IdeaPropulsionSystems/TimeLapseRail/TimeLapseRail/3D_Objects/170921_TinkercadScreenShotLabeled.jpg

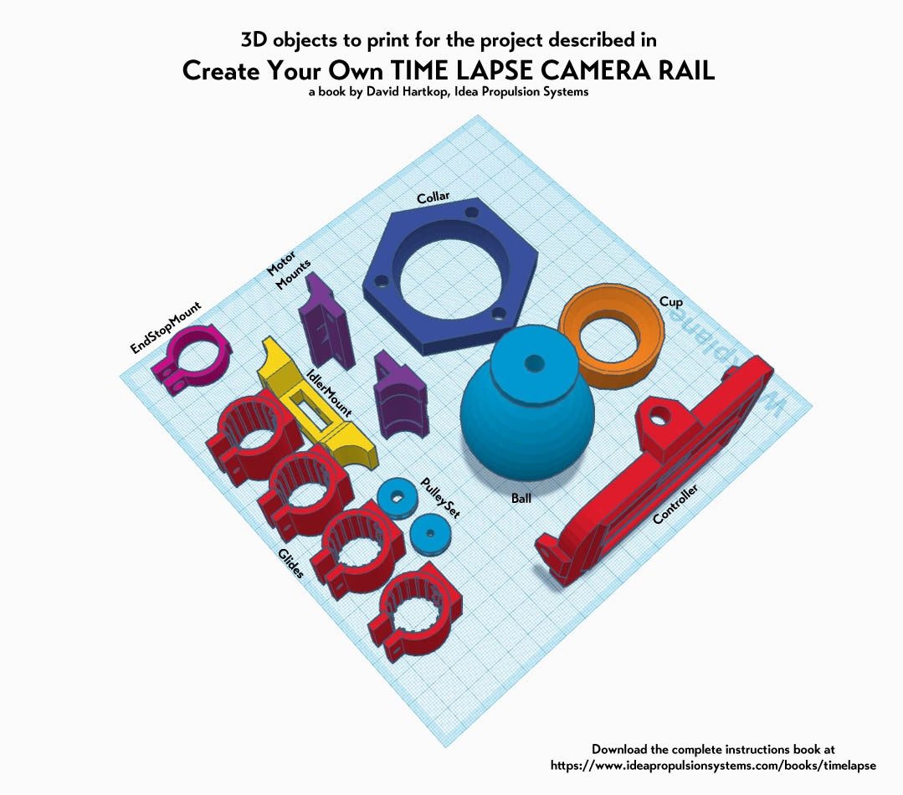
TimeLapseRail/3D_Objects/170921_TinkercadScreenShotLabeled.jpg
