IdeaPropulsionSystems/TimeLapseRail/TimeLapseRail/Notes/Time Lapse Table - Sheet1 (1).pdf

# How long do I have to sit here??!

Frames of TimeLapse
| 30 | 150 | 300 | 450 | 600 | 900 | 1800

Camera Interval

0:05 | 0:02:30 | 0:12:30 | 0:25:00 | 0:37:30 | 0:50:00 | 1:15:00 | 2:30:00
0:10 | 0:05:00 | 0:25:00 | 0:50:00 | 1:15:00 | 1:40:00 | 2:30:00 | 5:00:00
0:15 | 0:07:30 | 0:37:30 | 1:15:00 | 1:52:30 | 2:30:00 | 3:45:00 | 7:30:00
0:20 | 0:10:00 | 0:50:00 | 1:40:00 | 2:30:00 | 3:20:00 | 5:00:00 | 10:00:00
0:30 | 0:15:00 | 1:15:00 | 2:30:00 | 3:45:00 | 5:00:00 | 7:30:00 | 15:00:00
0:40 | 0:20:00 | 1:40:00 | 3:20:00 | 5:00:00 | 6:40:00 | 10:00:00 | 20:00:00
0:50 | 0:25:00 | 2:05:00 | 4:10:00 | 6:15:00 | 8:20:00 | 12:30:00 | 25:00:00
1:00 | 0:30:00 | 2:30:00 | 5:00:00 | 7:30:00 | 10:00:00 | 15:00:00 | 30:00:00
2:00 | 1:00:00 | 5:00:00 | 10:00:00 | 15:00:00 | 20:00:00 | 30:00:00 | 60:00:00
| 1 | 5 | 10 | 15 | 20 | 30 | 60
Seconds of TimeLapse (30fps)
