IdeaPropulsionSystems/TimeLapseRail/TimeLapseRail/Notes/CamRail_3DPartslist - Sheet1.pdf

Part No. | Part Name | File Name | *Print Profile | Print Time (hr : min) | Weight (g) | Quantity
1 | Camera Mount Ball | 170708_Ball.stl | A | 1:45 | 45 | 1
2 | Controller Panel Face | 170708_Controller.stl | A | 1:30 | 30.5 | 1
3 | Idler Pulley Mount | 170708_IdlerMount.stl | A | 0:25 | 9 | 1
4 | Motor Mounts | 170708_MotorMounts.stl | A | 0:34 | 12 | 1
5 | Camera Mount Collar | 170708_Collar.stl | A | 0:48 | 19 | 1
6 | Endstop Switch Mount | 170708_EndstopMount.stl | A | 0:07 | 3 | 1
7 | Linear Bearing Glides | 170708_Glides.stl | A | 1:43 | 32 | 1
8 | Pulley Set | 170708_PulleySet.stl | B | 0:04 | 1.5 | 1
9 | Camera Mount Cup | 170708_Cup.stl | C | 0:17 | 6.2 | 1

*Print Profiles:
A: 0.2 mm layer thickness, 3 shells, 50% infill, raft + supports
B: 0.2 mm layer thickness, 3 shells, 100% infill, no raft or supports C: 0.2 mm layer thickness, 2 shells, 25% infill, no raft or supports
