IdeaPropulsionSystems/TimeLapseRail/TimeLapseRail/3D_Objects/170921_EndStopMount.stl

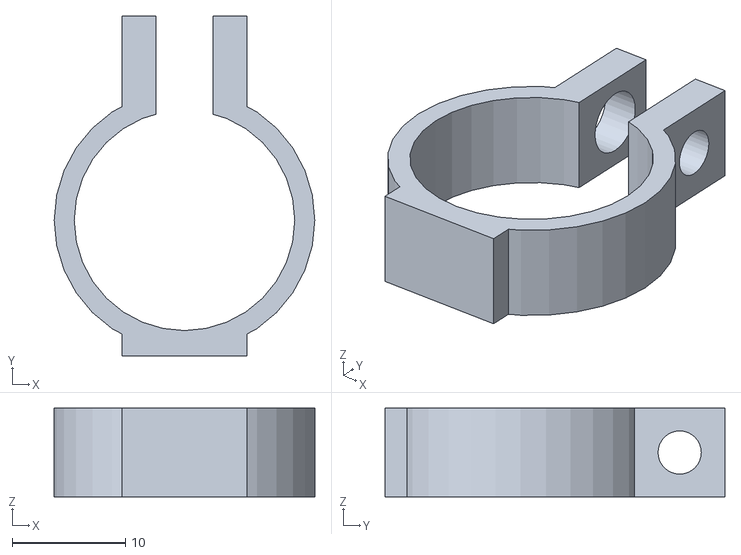
[picture p2: CAD file, 2017-09-21]
TimeLapseRail/3D_Objects/170921_EndStopMount.stl
23.0 x 30.0 x 7.84
