IdeaPropulsionSystems/TimeLapseRail/TimeLapseRail/3D_Objects/170921_Controller.stl

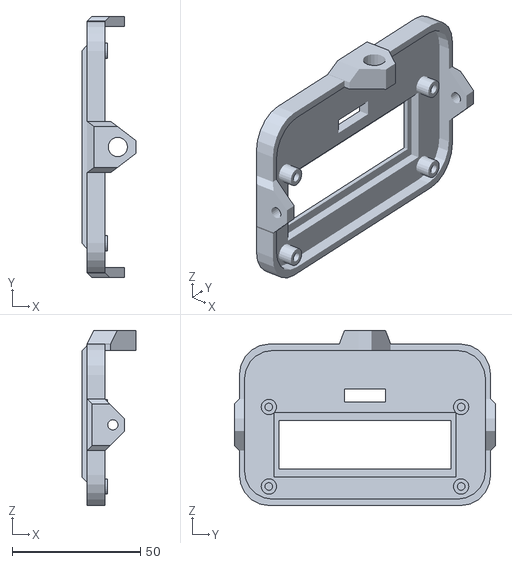
[picture p3: CAD file, 2017-09-21]
TimeLapseRail/3D_Objects/170921_Controller.stl
21.0 x 102.0 x 68.3
