IdeaPropulsionSystems/TimeLapseRail/TimeLapseRail/3D_Objects/170921_PulleySet.stl

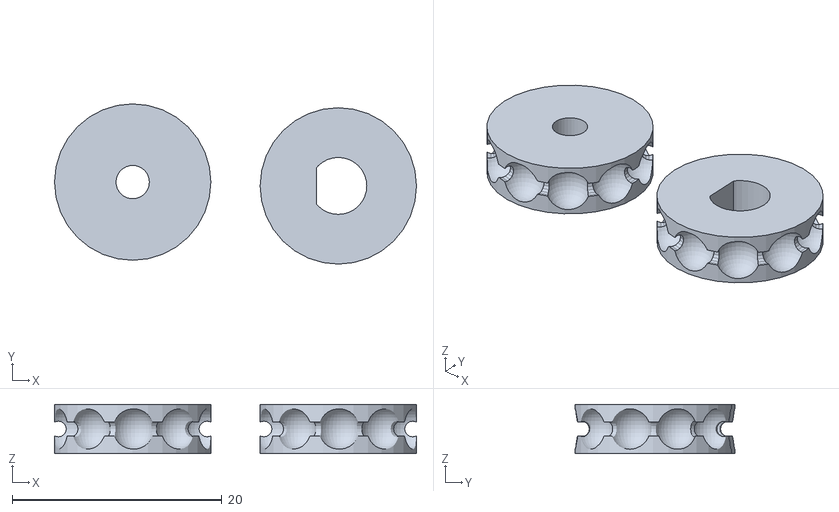
[picture p4: CAD file, 2017-09-21]
TimeLapseRail/3D_Objects/170921_PulleySet.stl
34.5 x 15.3 x 4.71
