IdeaPropulsionSystems/TimeLapseRail/TimeLapseRail/3D_Objects/170921_Glides.stl

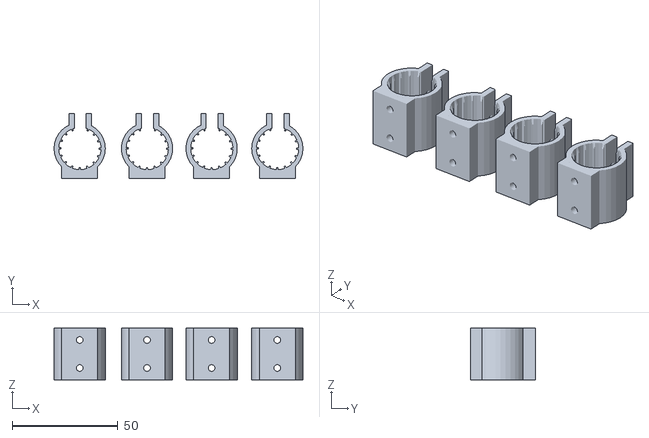
[picture p5: CAD file, 2017-09-21]
TimeLapseRail/3D_Objects/170921_Glides.stl
117.7 x 30.9 x 24.5
