IdeaPropulsionSystems/TimeLapseRail/TimeLapseRail/3D_Objects/170921_Cup.stl

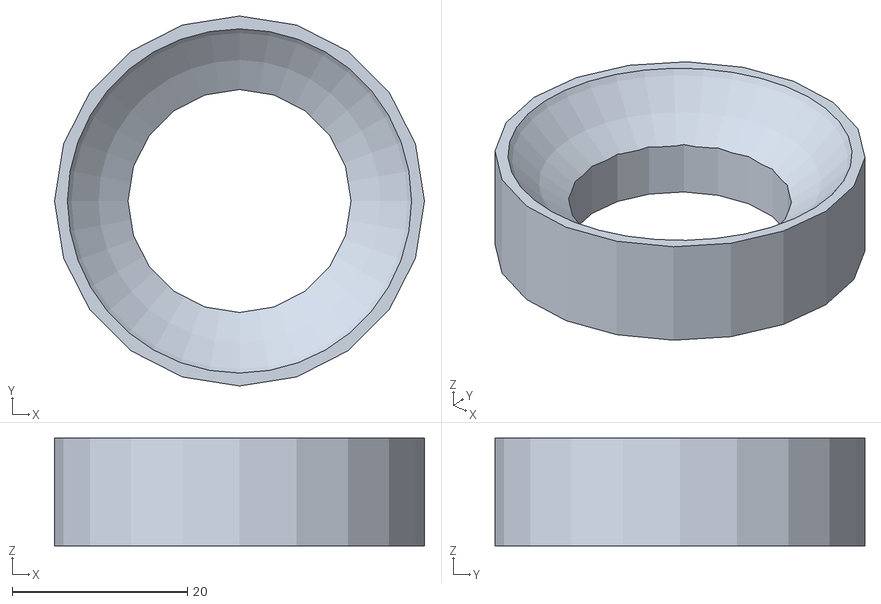
[picture p6: CAD file, 2017-09-21]
TimeLapseRail/3D_Objects/170921_Cup.stl
42.2 x 42.2 x 12.3
