IdeaPropulsionSystems/TimeLapseRail/TimeLapseRail/3D_Objects/170921_Collar.stl

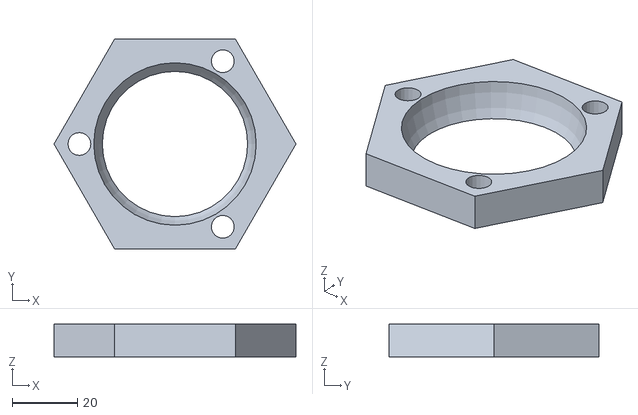
[picture p7: CAD file, 2017-09-21]
TimeLapseRail/3D_Objects/170921_Collar.stl
74.2 x 64.2 x 10.00
