IdeaPropulsionSystems/TimeLapseRail/TimeLapseRail/3D_Objects/170921_IdlerMount.stl

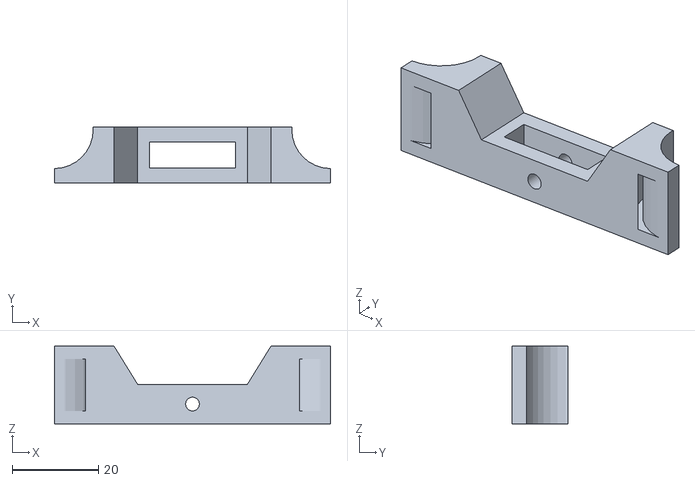
[picture p8: CAD file, 2017-09-21]
TimeLapseRail/3D_Objects/170921_IdlerMount.stl
64.0 x 13.0 x 18.0
