IdeaPropulsionSystems/TimeLapseRail/TimeLapseRail/3D_Objects/170921_MotorMounts.stl

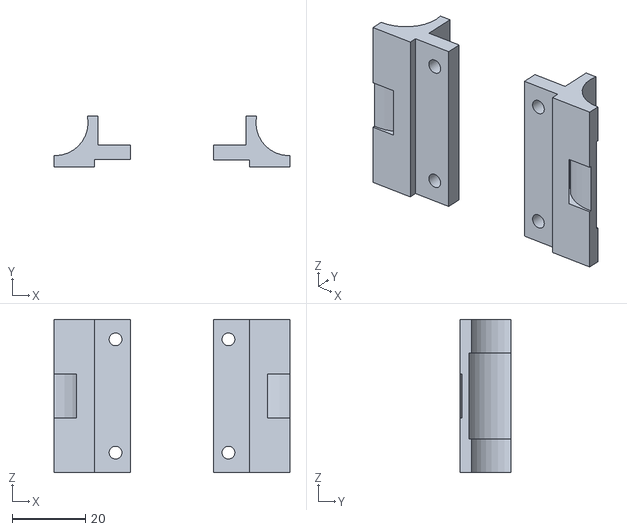
[picture p9: CAD file, 2017-09-21]
TimeLapseRail/3D_Objects/170921_MotorMounts.stl
64.6 x 14.0 x 42.0
