IdeaPropulsionSystems/TimeLapseRail/TimeLapseRail/3D_Objects/170921_Ball.stl

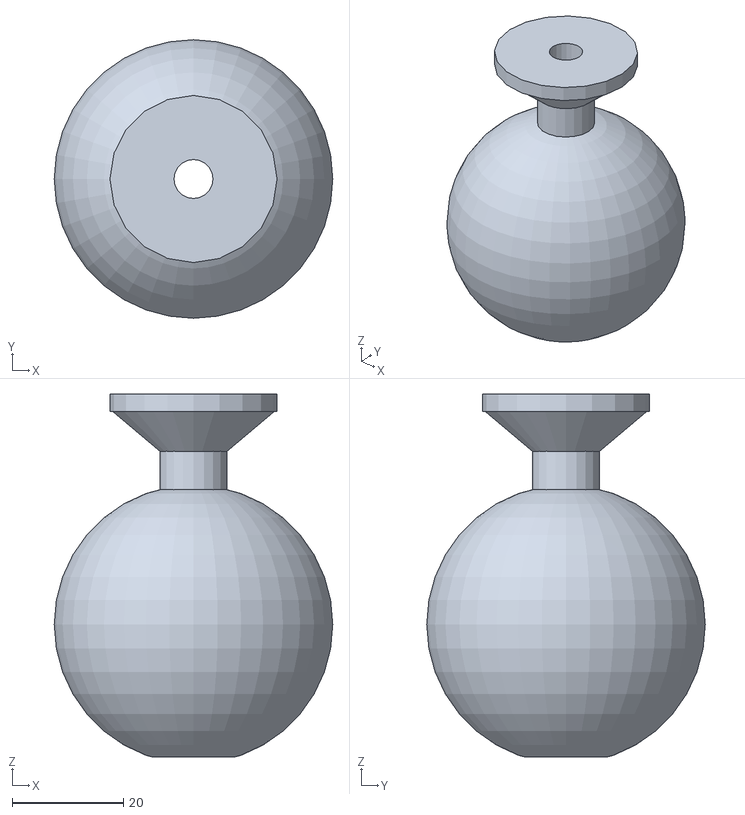
[picture p10: CAD file, 2017-09-21]
TimeLapseRail/3D_Objects/170921_Ball.stl
50.0 x 50.0 x 65.2
