IdeaPropulsionSystems/TimeLapseRail/(commit log)

2017-07-19 TimeLapse firmware for motorized camera rail
2017-07-19 Picture of the Time Lapse Rail in use
2017-07-19 TimeLapse Rail software updated
2017-09-21 Updated on 170921
    [170921_Ball.stl, 170921_Collar.stl, 170921_Controller.stl, 170921_Cup.stl, 170921_EndStopMount.stl, 170921_Glides.stl, 170921_IdlerMount.stl, 170921_MotorMounts.stl]
